Delaunay/keyboards/split/v3/outlines/caps.dxf

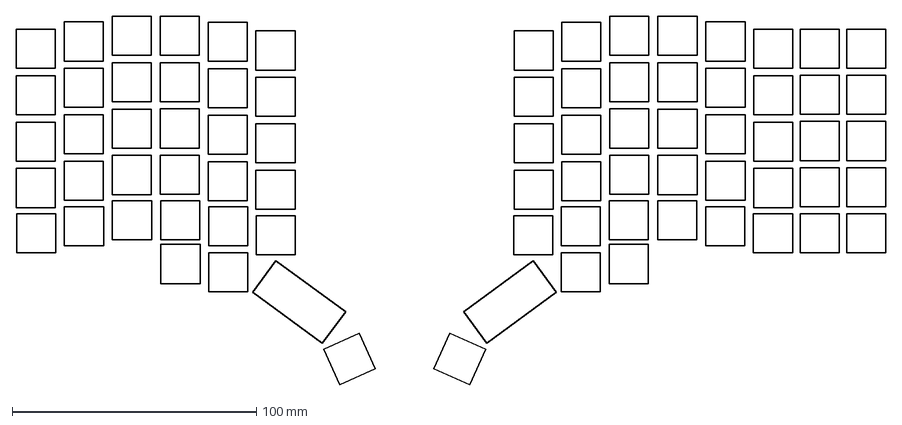
[picture p1: CAD file, 2026-11-07]
split/v3/outlines/caps.dxf
355.8 x 150.9 mm
