Delaunay/keyboards/split/v3/outlines/board.dxf

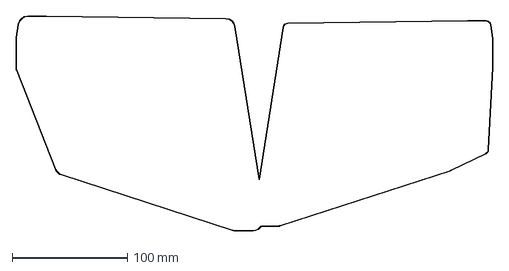
[picture p2: CAD file, 2026-11-07]
split/v3/outlines/board.dxf
413.8 x 186.0 mm
