Delaunay/keyboards/split/v1/outputs_mx/outlines/print.dxf

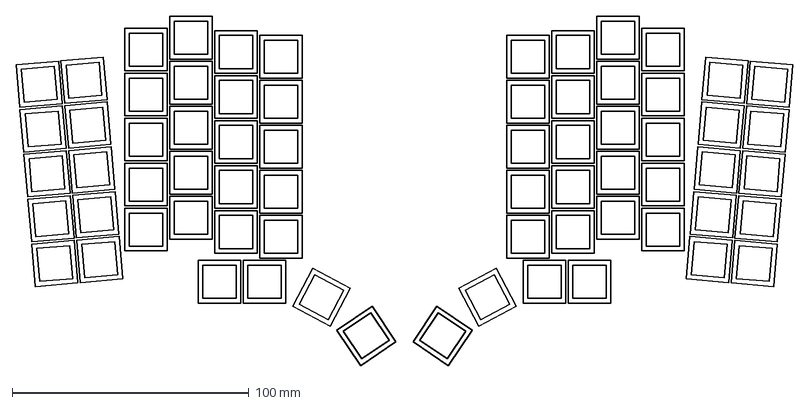
[picture p3: CAD file, 2026-10-02, an earlier design]
split/v1/outputs_mx/outlines/print.dxf
328.0 x 147.4 mm
