Delaunay/keyboards/split/v2/board.dxf

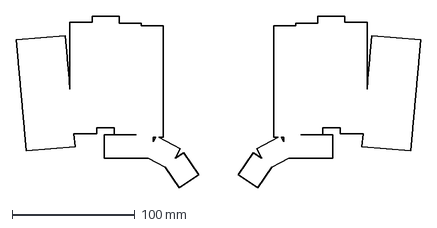
[picture p4: CAD file, 2026-11-02, an earlier design]
split/v2/board.dxf
329.6 x 140.3 mm
