Delaunay/keyboards/split/v1/outputs_mx/outlines/board.dxf

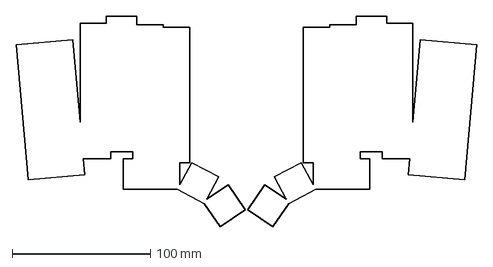
[picture p5: CAD file, 2026-10-02, an earlier design]
split/v1/outputs_mx/outlines/board.dxf
332.4 x 152.1 mm
