Delaunay/keyboards/split/v2/print.dxf

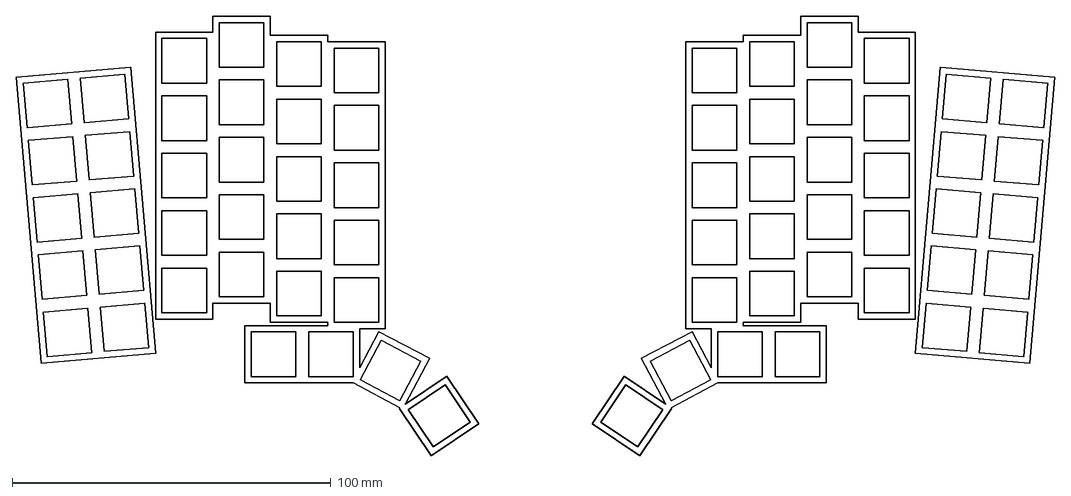
[picture p6: CAD file, 2026-11-02, an earlier design]
split/v2/print.dxf
325.5 x 137.8 mm
