Delaunay/keyboards/split/v3/pcbs/keyboard.kicad_pcb

## KiCad design split/v3/pcbs/keyboard.kicad_pcb (2026-11-07)

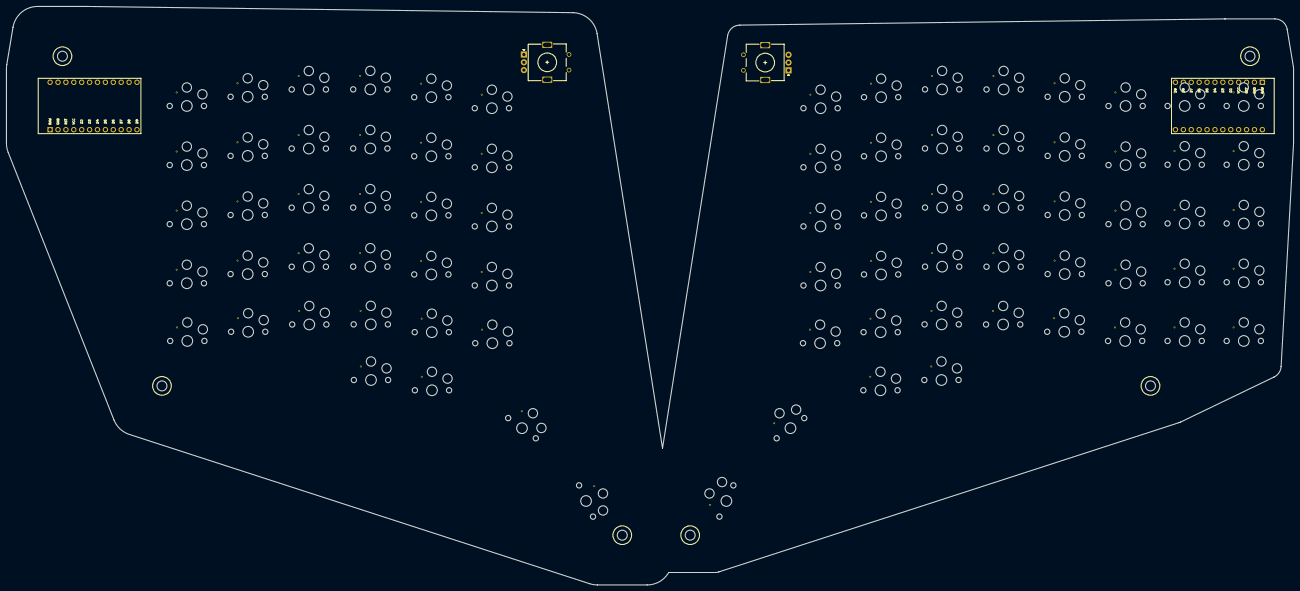
[picture p7: board split/v3/pcbs/keyboard.kicad_pcb from above]

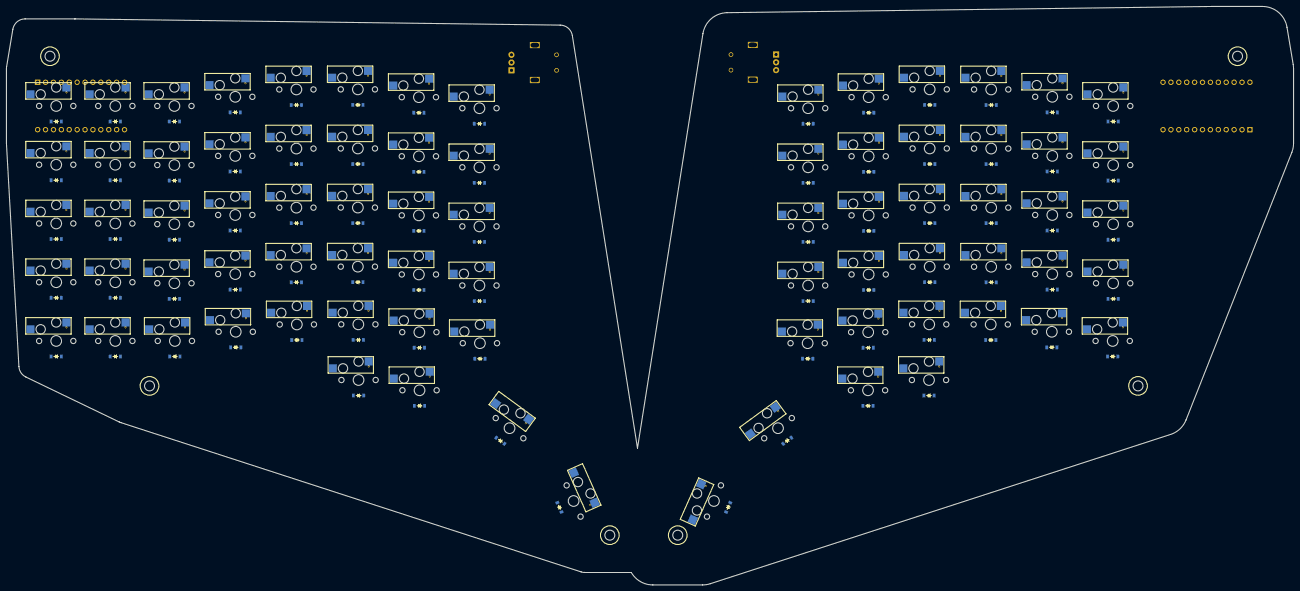
[picture p8: board split/v3/pcbs/keyboard.kicad_pcb from below]

Board: 2 copper layers, 413.8 x 186.0 mm, 244 parts (156 on the bottom side), 112 nets, no tracks yet.

Parts:
D1, D2, D3, D4, D5, D6, D7, D8, D9, D10, D11, D12, D13, D14, D15, D16, D17, D18, D19, D20, D21, D22, D23, D24, D25, D26, D27, D28, D29, D30, D31, D32, D33, D34, D35, D36, D37, D38, D39, D40, D41, D42, D43, D44, D45, D46, D47, D48, D49, D50, D51, D52, D53, D54, D55, D56, D57, D58, D59, D60, D61, D62, D63, D64, D65, D66, D67, D68, D69, D70, D71, D72, D73, D74, D75, D76, D77, D78: Diode_SMD_B
H1, H2, H3, H4, H5, H6: M3
HS1, HS2, HS3, HS4, HS5, HS6, HS7, HS8, HS9, HS10, HS11, HS12, HS13, HS14, HS15, HS16, HS17, HS18, HS19, HS20, HS21, HS22, HS23, HS24, HS25, HS26, HS27, HS28, HS29, HS30, HS31, HS32, HS33, HS34, HS35, HS36, HS37, HS38, HS39, HS40, HS41, HS42, HS43, HS44, HS45, HS46, HS47, HS48, HS49, HS50, HS51, HS52, HS53, HS54, HS55, HS56, HS57, HS58, HS59, HS60, HS61, HS62, HS63, HS64, HS65, HS66, HS67, HS68, HS69, HS70, HS71, HS72, HS73, HS74, HS75, HS76, HS77, HS78: Kailh_Choc_Hotswap
MCU1, MCU2: nice_nano_v2
ROT1, ROT2: rotary_encoder
S1, S2, S3, S4, S5, S6, S7, S8, S9, S10, S11, S12, S13, S14, S15, S16, S17, S18, S19, S20, S21, S22, S23, S24, S25, S26, S27, S28, S29, S30, S31, S32, S33, S34, S35, S36, S37, S38, S39, S40, S41, S42, S43, S44, S45, S46, S47, S48, S49, S50, S51, S52, S53, S54, S55, S56, S57, S58, S59, S60, S61, S62, S63, S64, S65, S66, S67, S68, S69, S70, S71, S72, S73, S74, S75, S76, S77, S78: Kailh_PG1350; PG1350

Connections:
L_COL_INDEX: HS5.1, HS11.1, HS17.1, HS23.1, HS29.1, HS33.1, MCU1.19
L_COL_INNER: HS6.1, HS12.1, HS18.1, HS24.1, HS30.1, MCU1.17
L_COL_MACRO: HS1.1, HS7.1, HS13.1, HS19.1, HS25.1, MCU1.22
L_COL_MIDDLE: HS4.1, HS10.1, HS16.1, HS22.1, HS28.1, HS32.1, MCU1.20
L_COL_PINKY: HS2.1, HS8.1, HS14.1, HS20.1, HS26.1, MCU1.11
L_COL_RING: HS3.1, HS9.1, HS15.1, HS21.1, HS27.1, HS31.1, MCU1.21
L_GND: MCU1.2, MCU1.15, MCU1.16, ROT1.2, ROT1.C
L_P8: MCU1.23, ROT1.B
L_P9: MCU1.24, ROT1.1
L_P20: MCU1.6, ROT1.A
L_ROW_BOT: D1.1, D2.1, D3.1, D4.1, D5.1, D6.1, MCU1.12
L_ROW_FN: D25.1, D26.1, D27.1, D28.1, D29.1, D30.1, MCU1.7
L_ROW_HOME: D7.1, D8.1, D9.1, D10.1, D11.1, D12.1, MCU1.10
L_ROW_NUMS: D19.1, D20.1, D21.1, D22.1, D23.1, D24.1, MCU1.8
L_ROW_THUMB: D31.1, D32.1, D33.1, D34.1, MCU1.18
L_ROW_TOP: D13.1, D14.1, D15.1, D16.1, D17.1, D18.1, MCU1.9
R_COL_BRACKET: HS35.1, HS36.1, HS37.1, HS38.1, HS39.1, MCU2.13
R_COL_INDEX: HS49.1, HS55.1, HS61.1, HS67.1, HS73.1, HS77.1, MCU2.19
R_COL_INNER: HS50.1, HS56.1, HS62.1, HS68.1, HS74.1, MCU2.17
R_COL_MACRO: HS45.1, HS51.1, HS57.1, HS63.1, HS69.1, MCU2.22
R_COL_MIDDLE: HS48.1, HS54.1, HS60.1, HS66.1, HS72.1, HS76.1, MCU2.20
R_COL_NAV: HS40.1, HS41.1, HS42.1, HS43.1, HS44.1, MCU2.5
R_COL_PINKY: HS46.1, HS52.1, HS58.1, HS64.1, HS70.1, MCU2.11
R_COL_RING: HS47.1, HS53.1, HS59.1, HS65.1, HS71.1, HS75.1, MCU2.21
R_GND: MCU2.2, MCU2.15, MCU2.16, ROT2.2, ROT2.C
R_P8: MCU2.23, ROT2.B
R_P9: MCU2.24, ROT2.1
R_P20: MCU2.6, ROT2.A
R_ROW_BOT: D35.1, D40.1, D45.1, D46.1, D47.1, D48.1, D49.1, D50.1, MCU2.12
R_ROW_FN: D39.1, D44.1, D69.1, D70.1, D71.1, D72.1, D73.1, D74.1, MCU2.7
R_ROW_HOME: D36.1, D41.1, D51.1, D52.1, D53.1, D54.1, D55.1, D56.1, MCU2.10
R_ROW_NUMS: D38.1, D43.1, D63.1, D64.1, D65.1, D66.1, D67.1, D68.1, MCU2.8
R_ROW_THUMB: D75.1, D76.1, D77.1, D78.1, MCU2.18
R_ROW_TOP: D37.1, D42.1, D57.1, D58.1, D59.1, D60.1, D61.1, D62.1, MCU2.9
matrix_bracket_bottom_at: D35.2, HS35.2
matrix_bracket_fn_at: D39.2, HS39.2
matrix_bracket_home_at: D36.2, HS36.2
matrix_bracket_nums_at: D38.2, HS38.2
matrix_bracket_top_at: D37.2, HS37.2
matrix_index_bottom_at: D5.2, HS5.2
matrix_index_fn_at: D29.2, HS29.2
matrix_index_home_at: D11.2, HS11.2
matrix_index_nums_at: D23.2, HS23.2
matrix_index_top_at: D17.2, HS17.2
matrix_inner_bottom_at: D6.2, HS6.2
matrix_inner_fn_at: D30.2, HS30.2
matrix_inner_home_at: D12.2, HS12.2
matrix_inner_nums_at: D24.2, HS24.2
matrix_inner_top_at: D18.2, HS18.2
matrix_macro_bottom_at: D1.2, HS1.2
matrix_macro_fn_at: D25.2, HS25.2
matrix_macro_home_at: D7.2, HS7.2
matrix_macro_nums_at: D19.2, HS19.2
matrix_macro_top_at: D13.2, HS13.2
matrix_middle_bottom_at: D4.2, HS4.2
matrix_middle_fn_at: D28.2, HS28.2
matrix_middle_home_at: D10.2, HS10.2
matrix_middle_nums_at: D22.2, HS22.2
matrix_middle_top_at: D16.2, HS16.2
matrix_nav_bottom_at: D40.2, HS40.2
matrix_nav_fn_at: D44.2, HS44.2
matrix_nav_home_at: D41.2, HS41.2
matrix_nav_nums_at: D43.2, HS43.2
matrix_nav_top_at: D42.2, HS42.2
matrix_pinky_bottom_at: D2.2, HS2.2
matrix_pinky_fn_at: D26.2, HS26.2
matrix_pinky_home_at: D8.2, HS8.2
matrix_pinky_nums_at: D20.2, HS20.2
matrix_pinky_top_at: D14.2, HS14.2
matrix_ring_bottom_at: D3.2, HS3.2
matrix_ring_fn_at: D27.2, HS27.2
matrix_ring_home_at: D9.2, HS9.2
matrix_ring_nums_at: D21.2, HS21.2
matrix_ring_top_at: D15.2, HS15.2
mirror_matrix_index_bottom_at: D49.2, HS49.2
mirror_matrix_index_fn_at: D73.2, HS73.2
mirror_matrix_index_home_at: D55.2, HS55.2
mirror_matrix_index_nums_at: D67.2, HS67.2
mirror_matrix_index_top_at: D61.2, HS61.2
mirror_matrix_inner_bottom_at: D50.2, HS50.2
mirror_matrix_inner_fn_at: D74.2, HS74.2
mirror_matrix_inner_home_at: D56.2, HS56.2
mirror_matrix_inner_nums_at: D68.2, HS68.2
mirror_matrix_inner_top_at: D62.2, HS62.2
mirror_matrix_macro_bottom_at: D45.2, HS45.2
mirror_matrix_macro_fn_at: D69.2, HS69.2
mirror_matrix_macro_home_at: D51.2, HS51.2
mirror_matrix_macro_nums_at: D63.2, HS63.2
mirror_matrix_macro_top_at: D57.2, HS57.2
mirror_matrix_middle_bottom_at: D48.2, HS48.2
mirror_matrix_middle_fn_at: D72.2, HS72.2
mirror_matrix_middle_home_at: D54.2, HS54.2
mirror_matrix_middle_nums_at: D66.2, HS66.2
mirror_matrix_middle_top_at: D60.2, HS60.2
mirror_matrix_pinky_bottom_at: D46.2, HS46.2
mirror_matrix_pinky_fn_at: D70.2, HS70.2
mirror_matrix_pinky_home_at: D52.2, HS52.2
mirror_matrix_pinky_nums_at: D64.2, HS64.2
mirror_matrix_pinky_top_at: D58.2, HS58.2
mirror_matrix_ring_bottom_at: D47.2, HS47.2
mirror_matrix_ring_fn_at: D71.2, HS71.2
mirror_matrix_ring_home_at: D53.2, HS53.2
mirror_matrix_ring_nums_at: D65.2, HS65.2
mirror_matrix_ring_top_at: D59.2, HS59.2
mirror_thumbs_index_thumb_at: D77.2, HS77.2
mirror_thumbs_middle_thumb_at: D76.2, HS76.2
mirror_thumbs_ring_thumb_at: D75.2, HS75.2
mirror_thumbs_thumb5_thumb_at: D78.2, HS78.2
thumbs_index_thumb_at: D33.2, HS33.2
thumbs_middle_thumb_at: D32.2, HS32.2
thumbs_ring_thumb_at: D31.2, HS31.2
thumbs_thumb5_thumb_at: D34.2, HS34.2
