Delaunay/keyboards/split/v1/outputs_mx/pcbs/keyboard.kicad_pcb

## KiCad design split/v1/outputs_mx/pcbs/keyboard.kicad_pcb (2026-10-02, an earlier design)

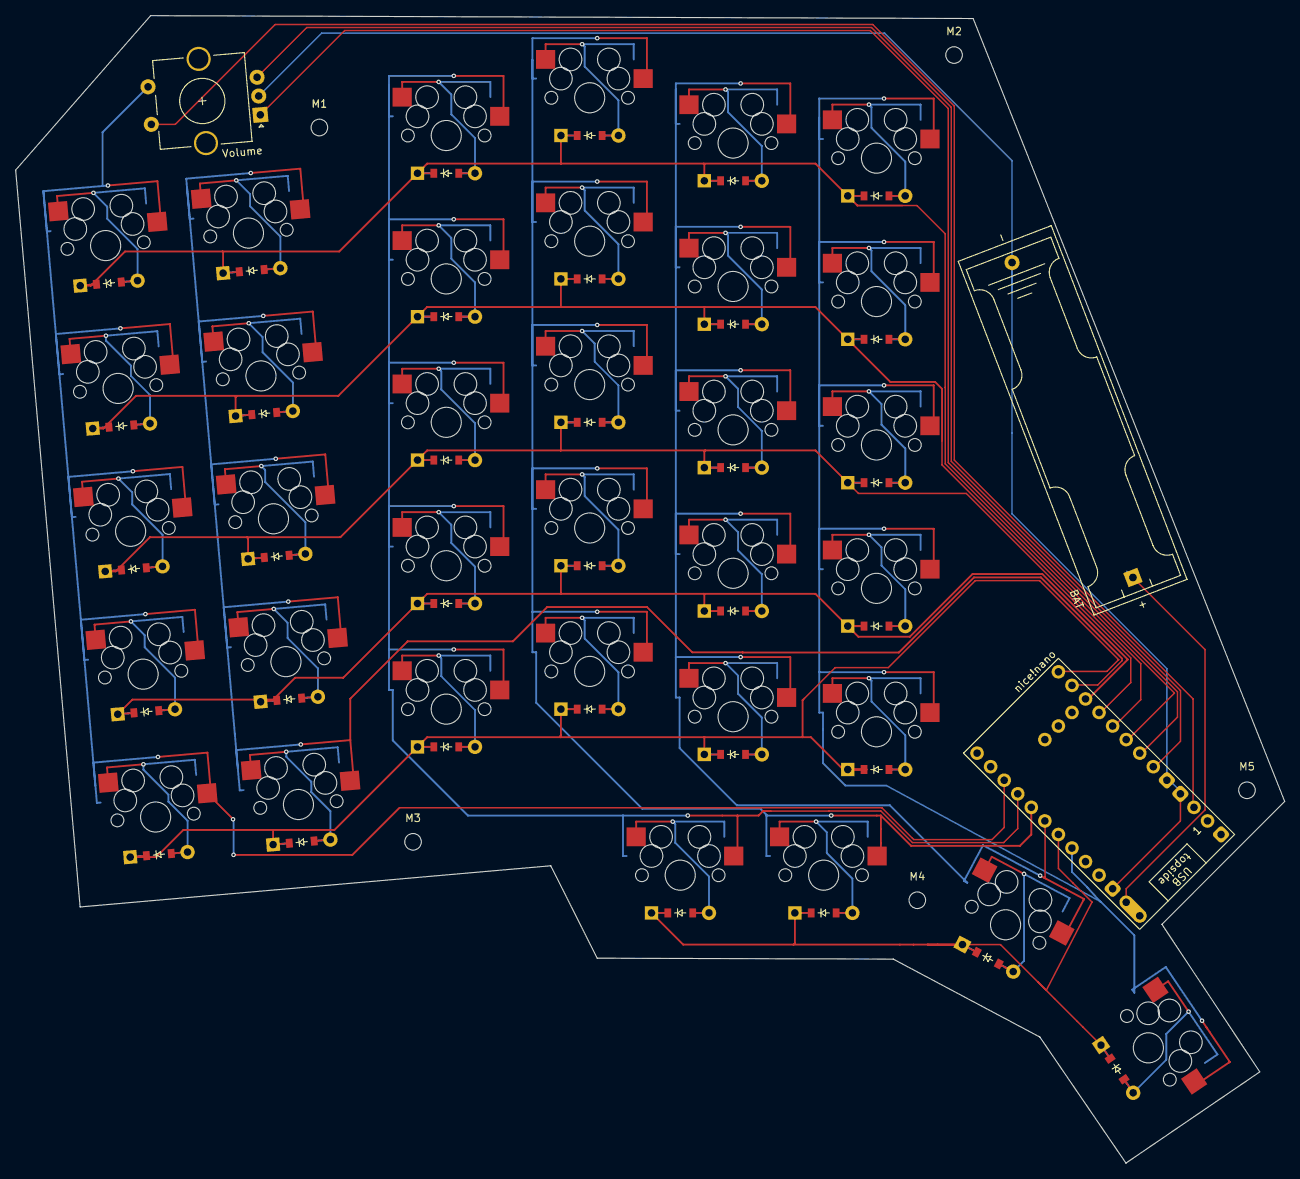
[picture p9: board split/v1/outputs_mx/pcbs/keyboard.kicad_pcb from above]

Board: 2 copper layers, 168.1 x 152.0 mm, 76 parts (0 on the bottom side), 51 nets.

Parts:
BAT: BatteryHolder_Keystone_2466_1xAAA
D1, D2, D3, D4, D5, D6, D7, D8, D9, D10, D11, D12, D13, D14, D15, D16, D17, D18, D19, D20, D21, D22, D23, D24, D25, D26, D27, D28, D29, D30, D31, D32, D33, D34: ComboDiode
M1, M2, M3, M4, M5: MountingHole_2.2mm_M2
S1, S2, S3, S4, S5, S6, S7, S8, S9, S10, S11, S12, S13, S14, S15, S16, S17, S18, S19, S20, S21, S22, S23, S24, S25, S26, S27, S28, S29, S30, S31, S32, S33, S34: MX
Volume: Encoder; RotaryEncoder_Alps_EC11E-Switch_Vertical_H20mm_CircularMoun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
nice!nano: nice!nano; nice_nano_AH_Reversible

Connections:
BAT: BAT.1, nice!nano.13, nice!nano.29
COL_INDEX: S21.1, S22.1, S23.1, S24.1, S25.1, S33.1, nice!nano.19
COL_INNER: S26.1, S27.1, S28.1, S29.1, S30.1, S34.1, nice!nano.17
COL_MACRO: S1.1, S2.1, S3.1, S4.1, S5.1, Volume.S1, nice!nano.22
COL_MIDDLE: S16.1, S17.1, S18.1, S19.1, S20.1, S32.1, nice!nano.20
COL_PINKY: S6.1, S7.1, S8.1, S9.1, S10.1, nice!nano.11
COL_RING: S11.1, S12.1, S13.1, S14.1, S15.1, S31.1, nice!nano.21
ENC_A: Volume.A, nice!nano.6
ENC_B: Volume.B, nice!nano.5
ENC_BTN: Volume.S2, nice!nano.2
GND: BAT.2, Volume.C, nice!nano.3, nice!nano.4, nice!nano.14
ROW_BOT: D1.1, D6.1, D11.1, D16.1, D21.1, D26.1, nice!nano.12
ROW_FN: D5.1, D10.1, D15.1, D20.1, D25.1, D30.1, nice!nano.7
ROW_HOME: D2.1, D7.1, D12.1, D17.1, D22.1, D27.1, nice!nano.10
ROW_NUMS: D4.1, D9.1, D14.1, D19.1, D24.1, D29.1, nice!nano.8
ROW_THUMB: D31.1, D32.1, D33.1, D34.1, nice!nano.18
ROW_TOP: D3.1, D8.1, D13.1, D18.1, D23.1, D28.1, nice!nano.9
far_thumb: D34.2, S34.2
home_thumb: D33.2, S33.2
index_bottom: D21.2, S21.2
index_fn: D25.2, S25.2
index_home: D22.2, S22.2
index_nums: D24.2, S24.2
index_top: D23.2, S23.2
inner_bottom: D26.2, S26.2
inner_fn: D30.2, S30.2
inner_home: D27.2, S27.2
inner_nums: D29.2, S29.2
inner_top: D28.2, S28.2
macro_bottom: D1.2, S1.2
macro_fn: D5.2, S5.2
macro_home: D2.2, S2.2
macro_nums: D4.2, S4.2
macro_top: D3.2, S3.2
middle_bottom: D16.2, S16.2
middle_fn: D20.2, S20.2
middle_home: D17.2, S17.2
middle_nums: D19.2, S19.2
middle_top: D18.2, S18.2
near_thumb: D32.2, S32.2
nearest_thumb: D31.2, S31.2
pinky_bottom: D6.2, S6.2
pinky_fn: D10.2, S10.2
pinky_home: D7.2, S7.2
pinky_nums: D9.2, S9.2
pinky_top: D8.2, S8.2
ring_bottom: D11.2, S11.2
ring_fn: D15.2, S15.2
ring_home: D12.2, S12.2
ring_nums: D14.2, S14.2
ring_top: D13.2, S13.2
